Asgragrt/KeyTao_schematic/keyboard.kicad_pcb

## KiCad design keyboard.kicad_pcb (2023-07-21)

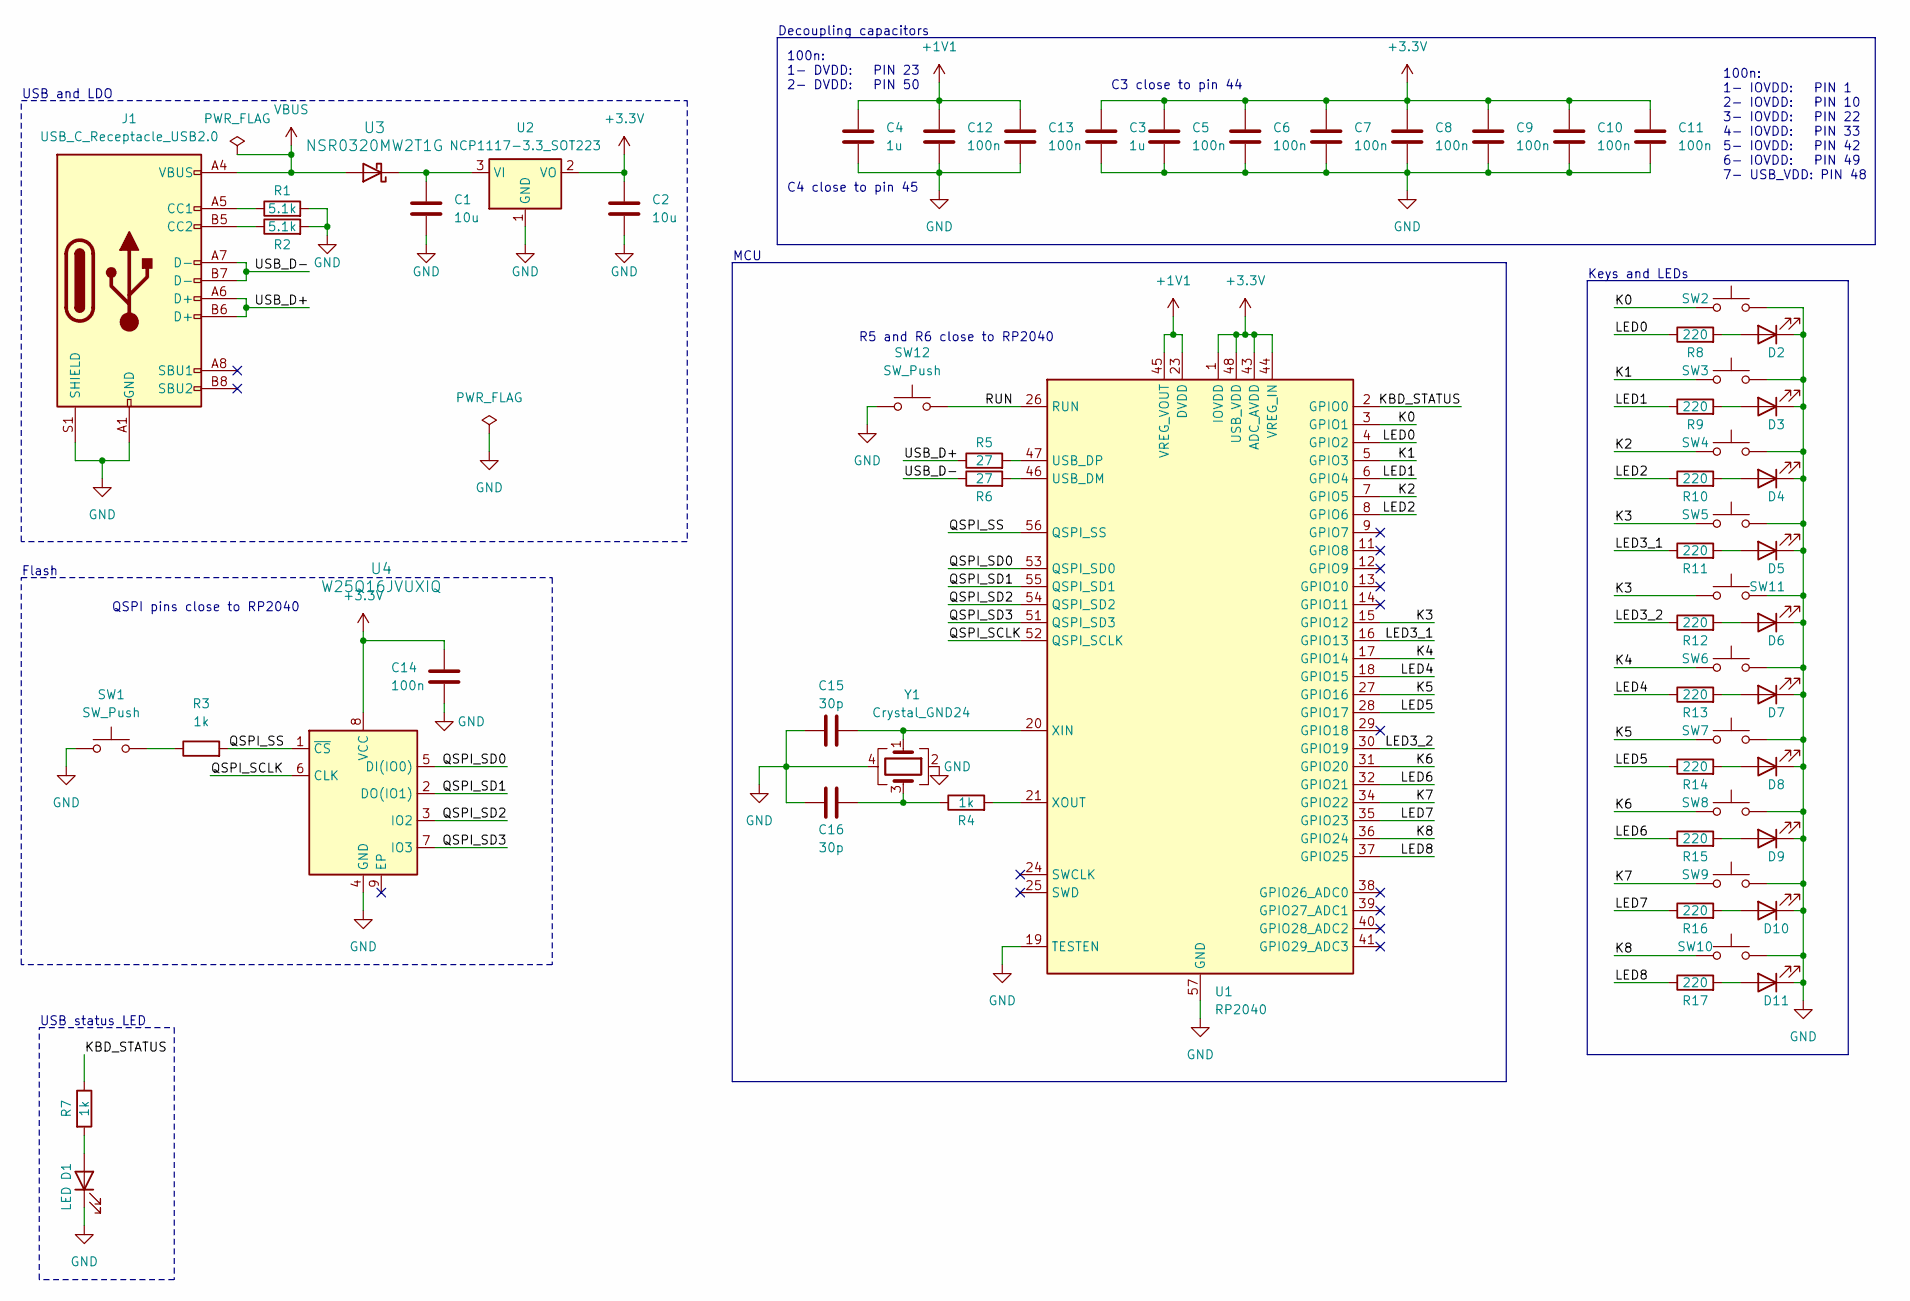
[picture p1: schematic keyboard.kicad_sch, Keytao 1]

Parts:
C1, C2: 10u; C_0402_1005Metric; JLCPCB Part# C15525
C3, C4: 1u; C_0402_1005Metric; JLCPCB Part# C52923
C5, C6, C7, C8, C9, C10, C11, C12, C13, C14: 100n; C_0402_1005Metric; JLCPCB Part# C1525
C15, C16: 30p; C_0402_1005Metric; JLCPCB Part# C1570
D1: LED; LED_0603_1608Metric; JLCPCB Part# C72038
D2, D3, D4, D5, D6, D7, D8, D9, D10, D11: LED; LED_0805_2012Metric; JLCPCB Part# C84256
J1: USB_C_Receptacle_USB2.0; USB_C_Receptacle_HRO_TYPE-C-31-M-12; JLCPCB Part# C165948
R1, R2: 5.1k; R_0805_2012Metric; JLCPCB Part# C27834
R3, R4, R7: 1k; R_0402_1005Metric; JLCPCB Part# C11702
R5, R6: 27; R_0603_1608Metric; JLCPCB Part# C25190
R8, R9, R10, R11, R12, R13, R14, R15, R16, R17: 220; R_0402_1005Metric; JLCPCB Part# C25091
SW1, SW12: SW_Push; SW_Push_1P1T_XKB_TS-1187A; JLCPCB Part# C318884
SW2, SW3, SW4, SW5, SW6, SW7, SW8, SW9, SW10, SW11: SW_Push; MXOnly-1U-Hotswap-Antishear_1; JLCPCB Part# C5156480
U1: RP2040; QFN-56-1EP_7x7mm_P0.4mm_EP3.2x3.2mm; JLCPCB Part# C2040
U2: NCP1117-3.3_SOT223; SOT-223-3_TabPin2; JLCPCB Part# C146799
U3: NSR0320MW2T1G; D_SOD-323; JLCPCB Part# C48192
U4: W25Q16JVUXIQ; W25Q16JVUXIQ_WIN; JLCPCB Part# C2843335
Y1: Crystal_GND24; Crystal_SMD_3225-4Pin_3.2x2.5mm; JLCPCB Part# C9002

Connections:
+1V1: C4.1, C12.1, C13.1, U1.23 (DVDD), U1.45 (VREG_VOUT), U1.50 (DVDD)
+3.3V: C2.1, C3.1, C5.1, C6.1, C7.1, C8.1, C9.1, C10.1, C11.1, C14.1, U1.1 (IOVDD), U1.10 (IOVDD), U1.22 (IOVDD), U1.33 (IOVDD), U1.42 (IOVDD), U1.43 (ADC_AVDD), U1.44 (VREG_IN), U1.48 (USB_VDD), U1.49 (IOVDD), U2.2 (VO), U4.8 (VCC)
/K0: SW2.2, U1.3 (GPIO1)
/K1: SW3.2, U1.5 (GPIO3)
/K2: SW4.2, U1.7 (GPIO5)
/K3: SW5.2, SW11.1, U1.15 (GPIO12)
/K4: SW6.2, U1.17 (GPIO14)
/K5: SW7.2, U1.27 (GPIO16)
/K6: SW8.2, U1.31 (GPIO20)
/K7: SW9.2, U1.34 (GPIO22)
/K8: SW10.2, U1.36 (GPIO24)
/KBD_STATUS: R7.1, U1.2 (GPIO0)
/LED0: R8.1, U1.4 (GPIO2)
/LED1: R9.1, U1.6 (GPIO4)
/LED2: R10.1, U1.8 (GPIO6)
/LED3_1: R11.1, U1.16 (GPIO13)
/LED3_2: R12.1, U1.30 (GPIO19)
/LED4: R13.1, U1.18 (GPIO15)
/LED5: R14.1, U1.28 (GPIO17)
/LED6: R15.1, U1.32 (GPIO21)
/LED7: R16.1, U1.35 (GPIO23)
/LED8: R17.1, U1.37 (GPIO25)
/QSPI_SCLK: U1.52 (QSPI_SCLK), U4.6 (CLK)
/QSPI_SD0: U1.53 (QSPI_SD0), U4.5 (DI(IO0))
/QSPI_SD1: U1.55 (QSPI_SD1), U4.2 (DO(IO1))
/QSPI_SD2: U1.54 (QSPI_SD2), U4.3 (IO2)
/QSPI_SD3: U1.51 (QSPI_SD3), U4.7 (IO3)
/QSPI_SS: R3.2, U1.56 (QSPI_SS), U4.1 (~CS)
/RUN: SW12.2, U1.26 (RUN)
/USB_D+: J1.A6 (D+), J1.B6 (D+), R5.1
/USB_D-: J1.A7 (D-), J1.B7 (D-), R6.1
GND: C1.2, C2.2, C3.2, C4.2, C5.2, C6.2, C7.2, C8.2, C9.2, C10.2, C11.2, C12.2, C13.2, C14.2, C15.1, C16.1, D1.1 (K), D2.1 (K), D3.1 (K), D4.1 (K), D5.1 (K), D6.1 (K), D7.1 (K), D8.1 (K), D9.1 (K), D10.1 (K), D11.1 (K), J1.A1 (GND), J1.A12 (GND), J1.B1 (GND), J1.B12 (GND), J1.S1 (SHIELD), R1.2, R2.2, SW1.1, SW2.1, SW3.1, SW4.1, SW5.1, SW6.1, SW7.1, SW8.1, SW9.1, SW10.1, SW11.2, SW12.1, U1.19 (TESTEN), U1.57 (GND), U2.1 (GND), U4.4 (GND), Y1.2, Y1.4
unnamed: C16.2, R4.1, Y1.3
unnamed: D1.2 (A), R7.2
unnamed: D2.2 (A), R8.2
unnamed: D3.2 (A), R9.2
unnamed: D4.2 (A), R10.2
unnamed: D5.2 (A), R11.2
unnamed: D6.2 (A), R12.2
unnamed: D7.2 (A), R13.2
unnamed: D8.2 (A), R14.2
unnamed: D9.2 (A), R15.2
unnamed: D10.2 (A), R16.2
unnamed: D11.2 (A), R17.2
unnamed: J1.A5 (CC1), R1.1
unnamed: J1.B5 (CC2), R2.1
unnamed: R3.1, SW1.2
unnamed: R6.2, U1.46 (USB_DM)
unnamed: R5.2, U1.47 (USB_DP)
unnamed: C15.2, U1.20 (XIN), Y1.1
unnamed: R4.2, U1.21 (XOUT)
unnamed: C1.1, U2.3 (VI), U3.1 (K)
VBUS: J1.A4 (VBUS), J1.A9 (VBUS), J1.B4 (VBUS), J1.B9 (VBUS), U3.2 (A)

Notes on the sheet:
C4 close to pin 45
100n: 1- IOVDD: PIN 1 2- IOVDD: PIN 10 3- IOVDD: PIN 22 4- IOVDD: PIN 33 5- IOVDD: PIN 42 6- IOVDD: PIN 49 7- USB_VDD: PIN 48
Keys and LEDs
MCU
Flash
QSPI pins close to RP2040
C3 close to pin 44
USB and LDO
USB status LED
100n: 1- DVDD: PIN 23 2- DVDD: PIN 50
R5 and R6 close to RP2040
Decoupling capacitors

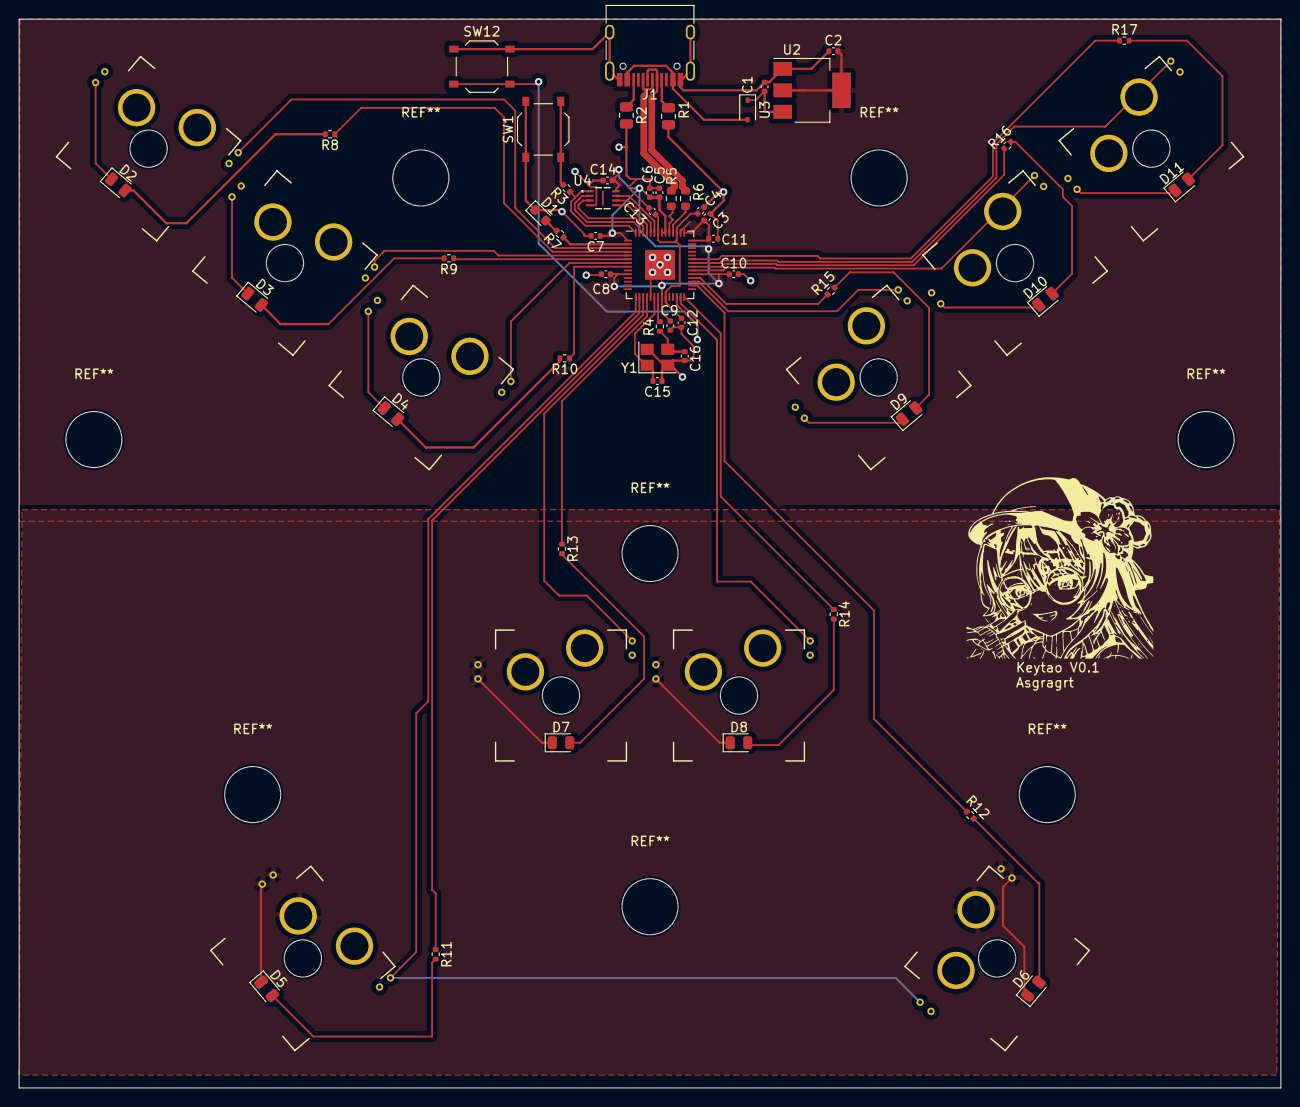
[picture p2: board keyboard.kicad_pcb from above]

Board: 2 copper layers, 135.0 x 114.4 mm, 62 parts (0 on the bottom side), 53 nets.
